bendelathouwer/Psoc_Robot/3d render voor poster.PNG

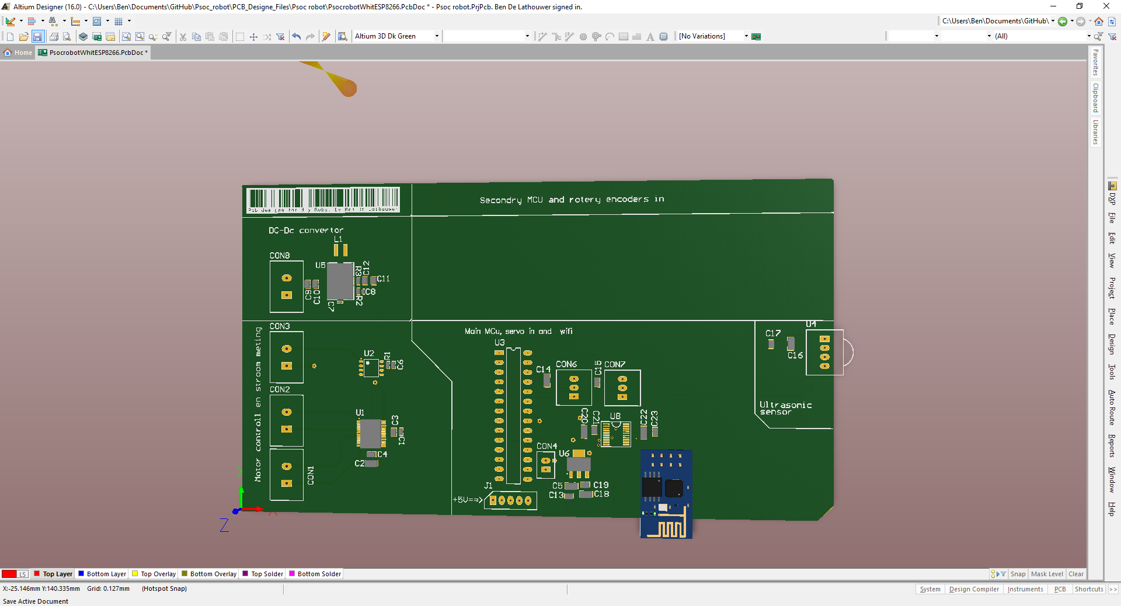
3d render voor poster.PNG
