bendelathouwer/Psoc_Robot/av/PCB_Designe_in progres.png

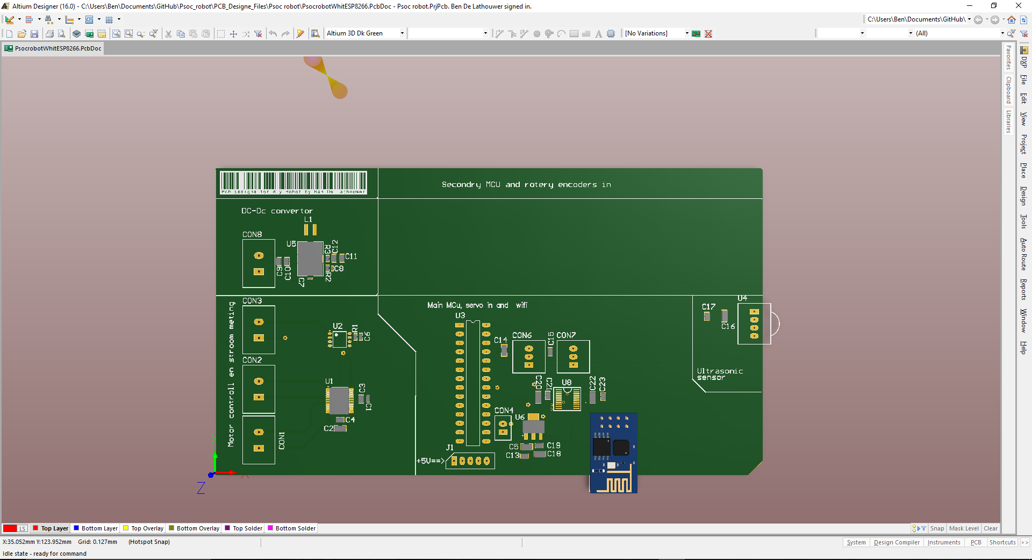
av/PCB_Designe_in progres.png
