bendelathouwer/Psoc_Robot/Psoc_robot/Psoc_robot/BuildMsg.txt

Starting MAKE...
creating project.mk 

lib/psocconfig.asm

lib/psocconfigtbl.asm

lib/pwm1.asm

lib/pwm1int.asm

lib/pwm2.asm

lib/pwm2int.asm

lib/timer1.asm

lib/timer1int.asm

lib/timer2.asm

lib/timer2int.asm

lib/timer3.asm

lib/timer3int.asm

lib/uart.asm

lib/uartint.asm

lib/uartplus.asm

./boot.asm

Linking..

LMM info: area 'InterruptRAM' uses 2 bytes in SRAM bank 0

LMM info: area 'UART_RAM' item of 16 bytes allocated in SRAM page 0

LMM info: area 'virtual_registers' uses 15 bytes in SRAM page 0

LMM info: area 'data' item of 2 bytes allocated in SRAM page 0

LMM info: area 'data' item of 2 bytes allocated in SRAM page 0

LMM info: area 'data' item of 2 bytes allocated in SRAM page 0

LMM info: area 'data' item of 2 bytes allocated in SRAM page 0

LMM info: area 'data' item of 2 bytes allocated in SRAM page 0

LMM info: area 'data' item of 2 bytes allocated in SRAM page 0

LMM info: area 'data' item of 2 bytes allocated in SRAM page 0

LMM info: area 'data' item of 2 bytes allocated in SRAM page 0

LMM info: area 'data' item of 2 bytes allocated in SRAM page 0

LMM info: area 'data' item of 1 bytes allocated in SRAM page 0

LMM info: area 'data' item of 1 bytes allocated in SRAM page 0

LMM info: area 'data' item of 1 bytes allocated in SRAM page 0

idata dump at output/Psoc_robot.idata

  ROM 19% full. 6030 out of 32768 bytes used (does not include absolute areas).

  RAM 4% full. 54 bytes used (does not include stack usage).

Built with ICCM8C STD V7.05.00

Psoc_robot - 0 error(s) 0 warning(s) 16:28:51
