bendelathouwer/Psoc_Robot/logboek2.odt

Logboek

woensdag 24/02/16 robot chasis halen 09:00=> 11 uur

Vrijdag 26/02/16 opzoeken afstands sensoren en werken aan project, propellor opblazen, ultrasoon sensor metingen 09:00=>20:00

zaterdag 27/02/2016 bestellen nieuw dev board + opzoeken gebruikte microcontroller+ datasheets verzamelen 19:00=>22:00

zondag 28/02/2016 pva schrijven en xbee's testen + uitlezen in labview nrf modulles testen 10:00=>00:00

donderdag programa verder schrijven en testen16:00 => 19:00 9 ben eveneens een baterij gaan halen (deze was leeg terwijl ik dacht mijn chip opgeblazen te hebben)

Vrijdag 09:00 =>13:00 stroomsensor board gaan halen

zaterdag 11:16=>11:47 stroommeting en beveiliging code schrijven+code opschonen

20:06=> 20:28 begin met website maken

Maandag 14/03/2016 17:19 =>19:00 Stress test procedure schrijven voor Hall efect stroom sensors

dinsdag 15/03/2016 10:20 =>10:30 print tekenen in altium

donderdag. 17/02/2016 16:10=> 21:23 libs maken in altium

vrijdag 17/03/2016 10:00=> 17:00 werken aan project

Zaterdag 19/03/2016 12:03=> 17:38 pcb tekene + ultrasoon sensor programmeren

zondag 20/03/2016 11:35=> 15:07 opnieuw programmeren van servo naar pwm code en uitbrijden voor het 2 joystick kanaal in te lezen

maandag 21/03/2016 10:00=>12:15 programmeren 2de joyjstick kanaal kunne uitlezen 50% done mark berijkt

donderdag 24/03/2016 10:00=>18:00 ultrasoon programmeren(proberen) en dc-dc convertor uitkiezen

donderdag 14/04/2016 08:15=> 14:00 pcb tekenen

/zondag 17/04/2016 13:20=>16:00 werken aan verslag

Vrijdag 22/04/2016 8:45 => schemas tekenen
