bendelathouwer/Psoc_Robot/project voorstel2/projectvoorstel2.odt

RC voertuig aansturen via xbee Ben De Lathouwer

Omschrijving : Fpga deel(VHDL):Mijn fpga gaat dienen als ground station.Onder ground station verstaan we een brod waarmee ik mijn helicopter op afstand mee kan bedienen.Eveneens ga ik hiermee een draadloze verbinding opzetten .Deze ga ik gebruiken om Vluchtdata mee te vusualiseren( onder vlucht data verstaan we bv de hoogte, snelheid, Richting,...).De visualisatie gaat gebeuren op een vga scherm( de visualisatie gaat in functie zijn van digitale project. De fpga interfacen met de xbee gaan zijn in functie van project project)

Vliegtuig gedeelte( C )

Deze gaat een bestuurings bort bevatten .Die de motoren gaan aansturen en de instrumenten gaat uitlezen .En Deze telemetrie gaat doorgestraald worden met een xbee module .

Xbee modullen . Zender blokschema:

Vga scherm FPGA FPGA FPGA

Xbee modullen . ontvanger boordcomputer boordcomputer

Telemetrie En motor stuuring

kostenraming

quadcopter 500 euro

fpga :80 euro

Print 10 euro

telemetrie:20 euro

totaal:610 euroqq
