bendelathouwer/Psoc_Robot/cross reference chart distance sensors.pdf

Blad1

vergelijkings chart afstand sensoren

type sensor | working current
HC – SR04 | 15mA
Sharp GP2YOA21 | Max 40mA
laser rage finder | 150 mA
ping sensor | 35 mA
Sonar sensor | 10mA

max dedection distance | mesuring angel
4m | 15degrees
Max 150 cm | Not found
2.54meters | Not found
3 m | Not found
5meters | Not found

price | max working voltage
€ 42,34 | 5V
: € 18,09 | 4.5 to 5.5V
| +4.5 V to +5.5 V
| +5 VDC

€ 41,14

€ 119,79

€ 36,29

12vdc (8vdc -
14vdc)

minj range | mesuering methode
2cm | ultrasound
20cm | IR
15cm | laser
: 2 cm | ultrasoon
60cm | sonar

remarks

2 pins needed trig and echo

Analog output voltage proportional to distance

high acuracy

1 pin needed to mesure distance

high distance but higer suply voltgae RS485 communication interface
