bendelathouwer/Psoc_Robot/Poort hexwaarde tabel.pdf

Poort nr | 7 | 6 | 5 | 4 | 3 | 2 | 1 | 0 | Hexwaarde | Schema naam | I | O
P2[7] | 1 | 0 | 0 | 0 | 0 | 0 | 0 | 0 | 0x80 | MOCA1A | | x | pin numer 568
p2[5] | 0 | 0 | 1 | 0 | 0 | 0 | 0 | 0 | 0x20 | MOCA1B | | x
p2[1] | 0 | 0 | 0 | 0 | 0 | 0 | 1 | 0 | 0x02 | MOCA2A | | x
p1[7] | 1 | 0 | 0 | 0 | 0 | 0 | 0 | 0 | 0x80 | MOCA2B | | x | 10
p1[5] | 0 | 0 | 1 | 0 | 0 | 0 | 0 | 0 | 0x20 | Stby | | x | 11
p2[6] | 0 | 1 | 0 | 0 | 0 | 0 | 0 | 0 | 0x40 | Fault | x | | 23
p2[2] | 0 | 0 | 0 | 0 | 0 | 1 | 0 | 0 | 0x04 | OE | | x | 21
p2[0] | 0 | 0 | 0 | 0 | 0 | 0 | 0 | 1 | 0x01 | GPIO2 | | | 20
P1[6] | 0 | 1 | 0 | 0 | 0 | 0 | 0 | 0 | 0x40 | CH_PD | | | 18
p1[4] | 0 | 0 | 0 | 1 | 0 | 0 | 0 | 0 | 0x10 | GPIO0 | | | 17
p1[2] | 0 | 0 | 0 | 0 | 0 | 1 | 0 | 0 | 0x04 | GPIO16 | | | 16
