bendelathouwer/Psoc_Robot/av/20160522_125724.jpg

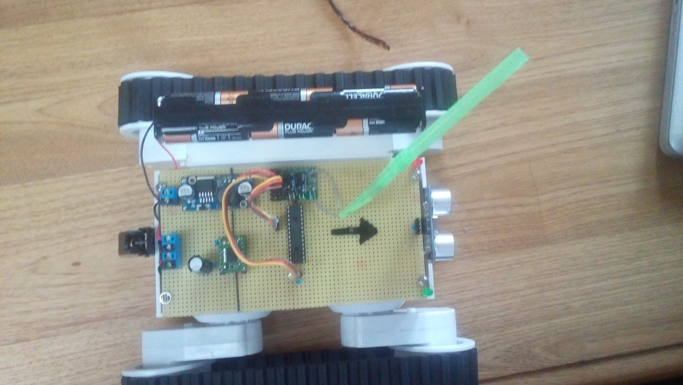
av/20160522_125724.jpg
