bendelathouwer/Psoc_Robot/av/20160522_132219.jpg

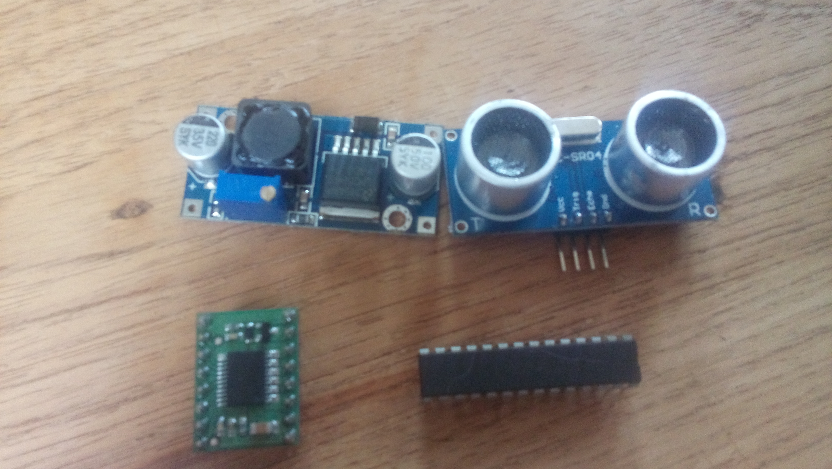
av/20160522_132219.jpg
