bendelathouwer/Psoc_Robot/av/IMG_5507.JPG

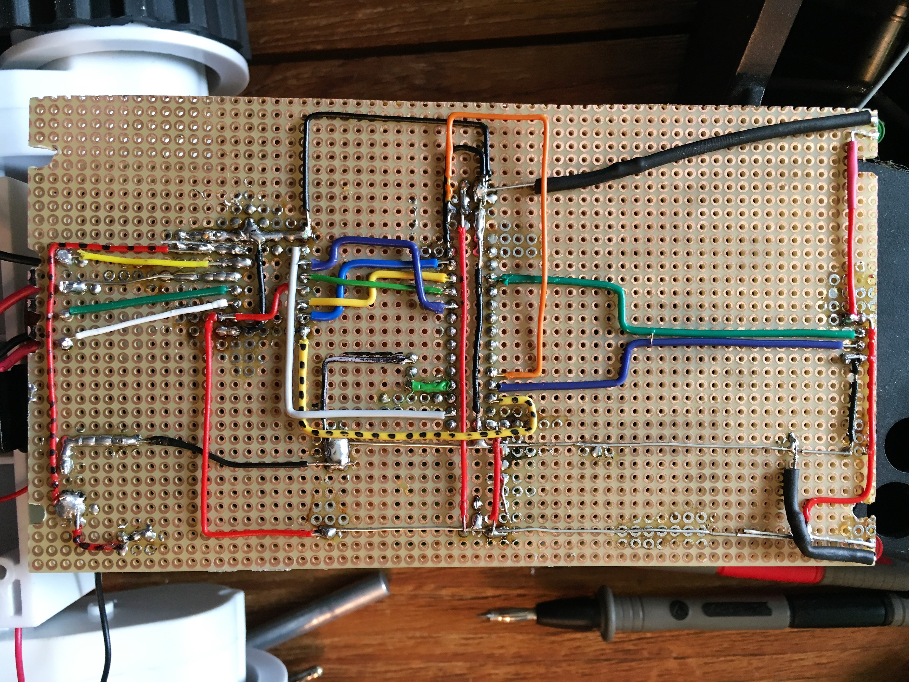
av/IMG_5507.JPG
