bendelathouwer/Psoc_Robot/av/IMG_5508.JPG

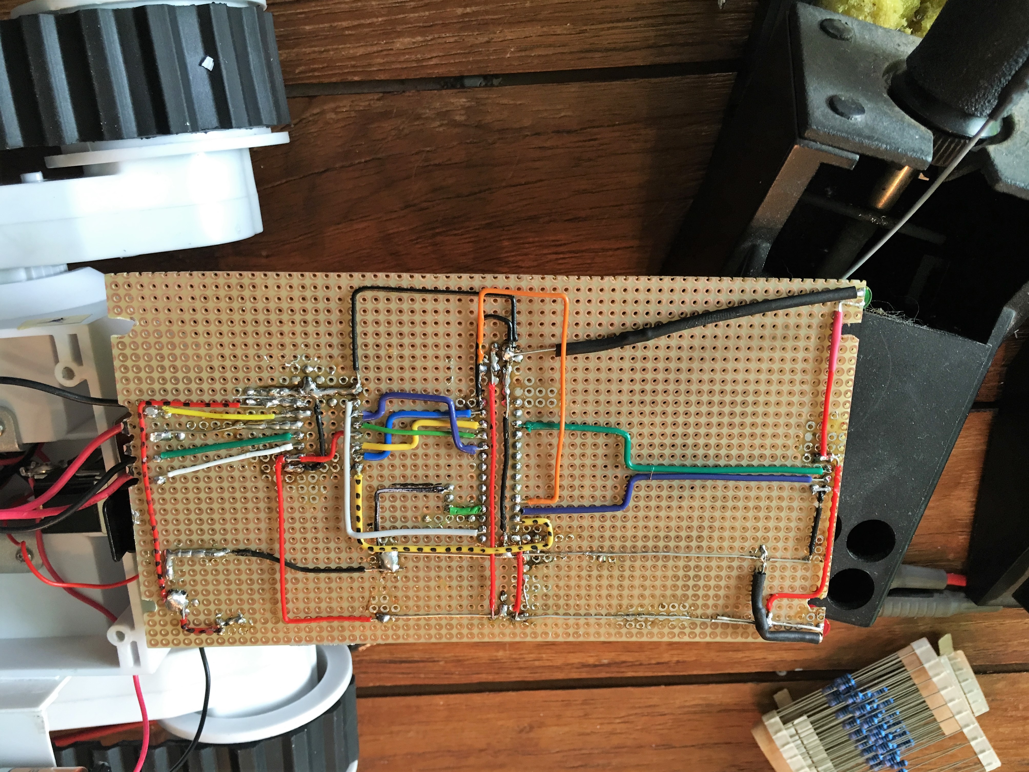
av/IMG_5508.JPG
