bendelathouwer/Psoc_Robot/av/IMG_5509.JPG

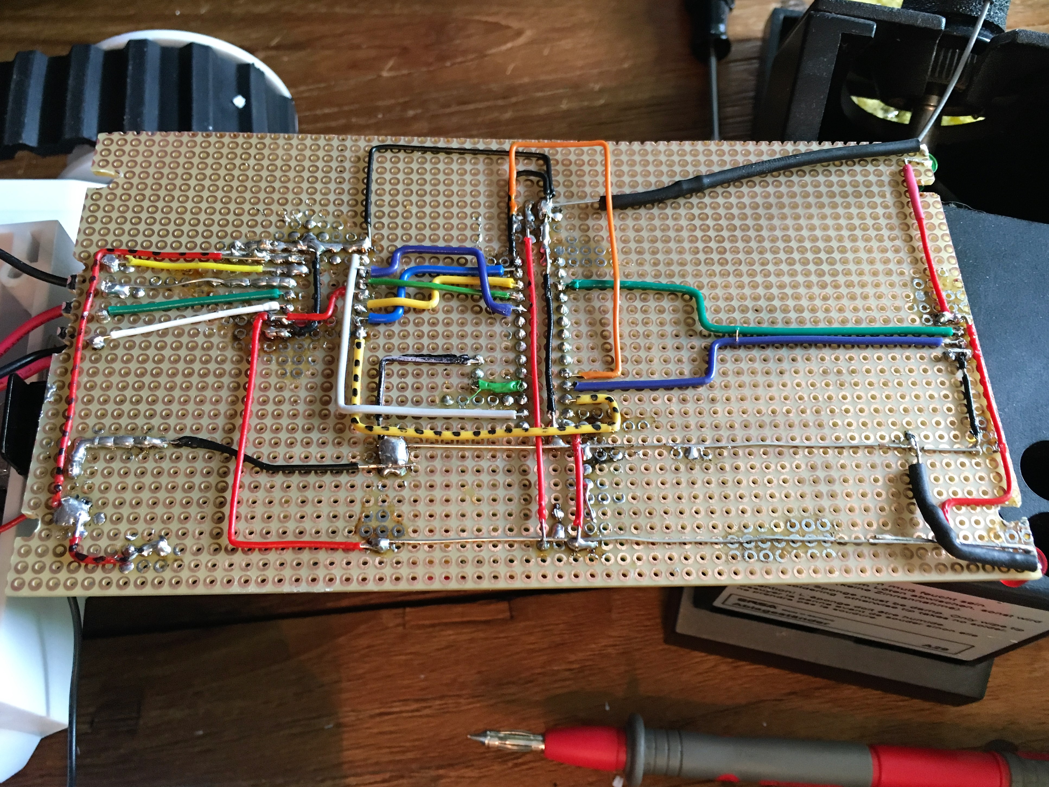
av/IMG_5509.JPG
