bendelathouwer/Psoc_Robot/av/IMG_5510.JPG

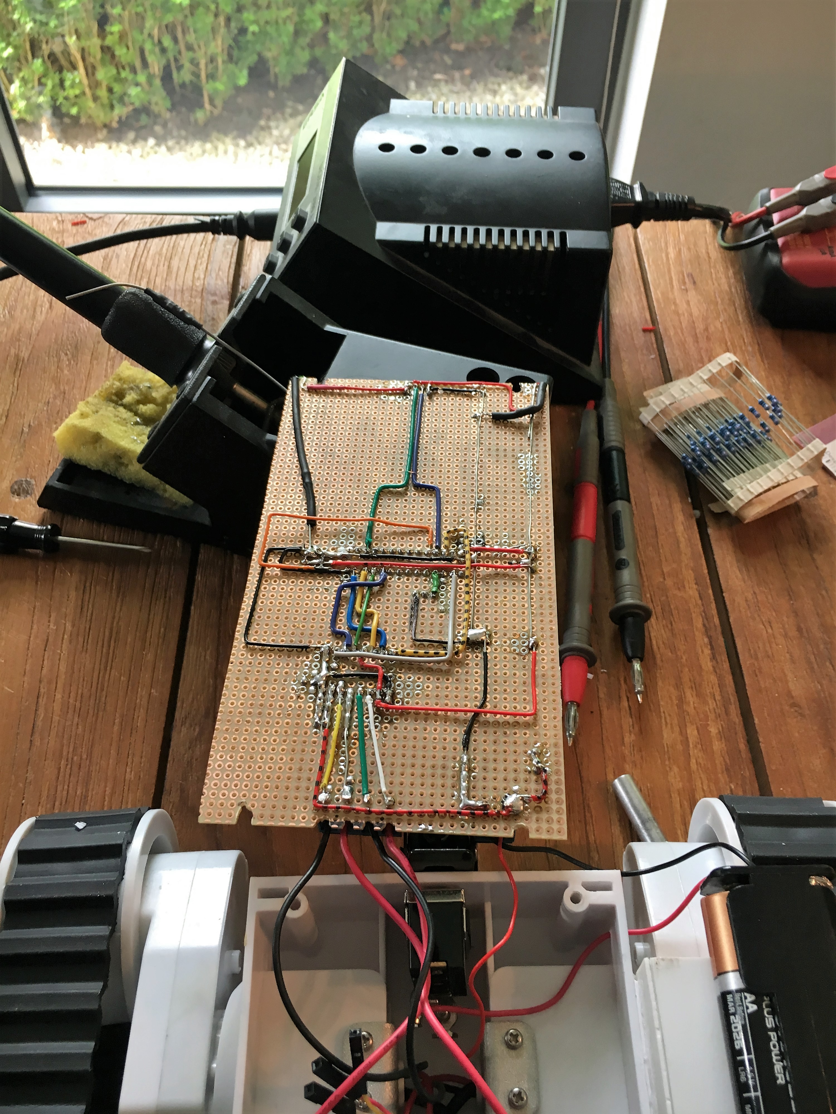
av/IMG_5510.JPG
