bendelathouwer/Psoc_Robot/av/IMG_5511.JPG

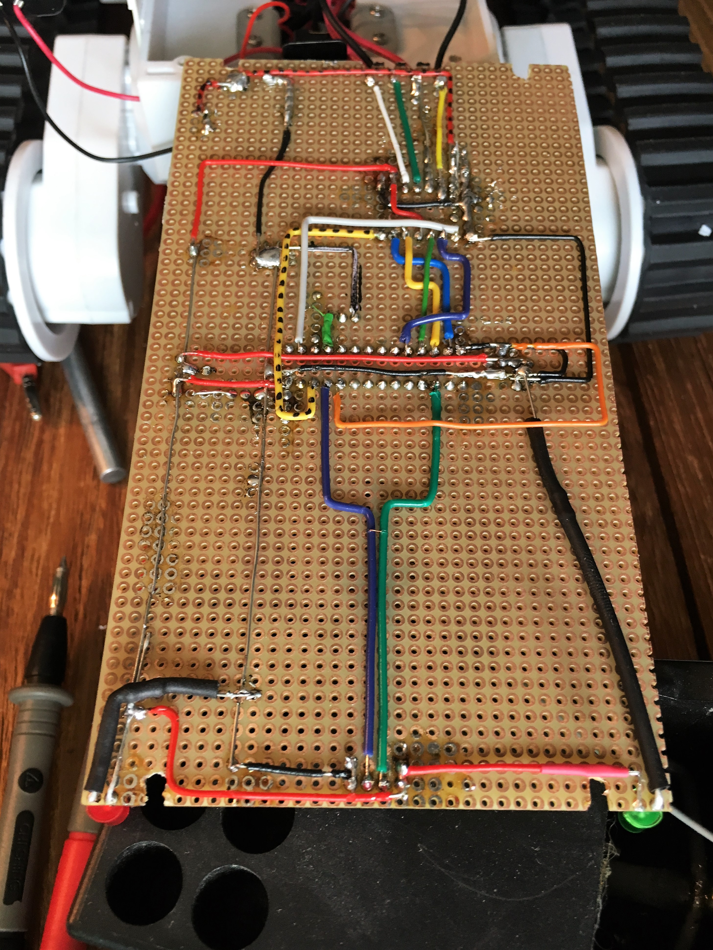
av/IMG_5511.JPG
