bendelathouwer/Psoc_Robot/av/IMG_5512.JPG

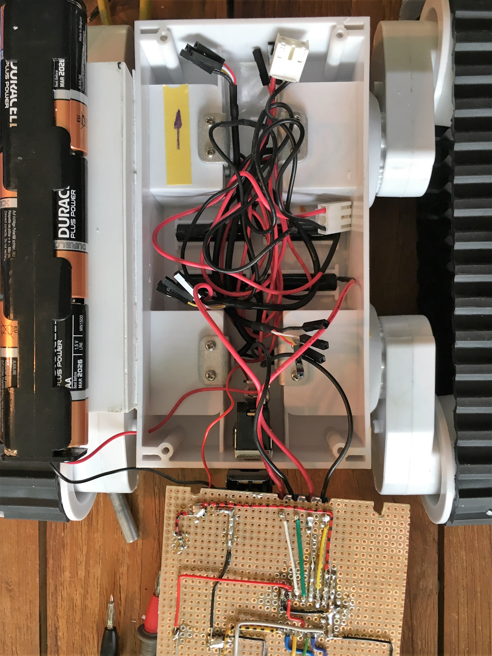
av/IMG_5512.JPG
