bendelathouwer/Psoc_Robot/av/interne van motordriver.PNG

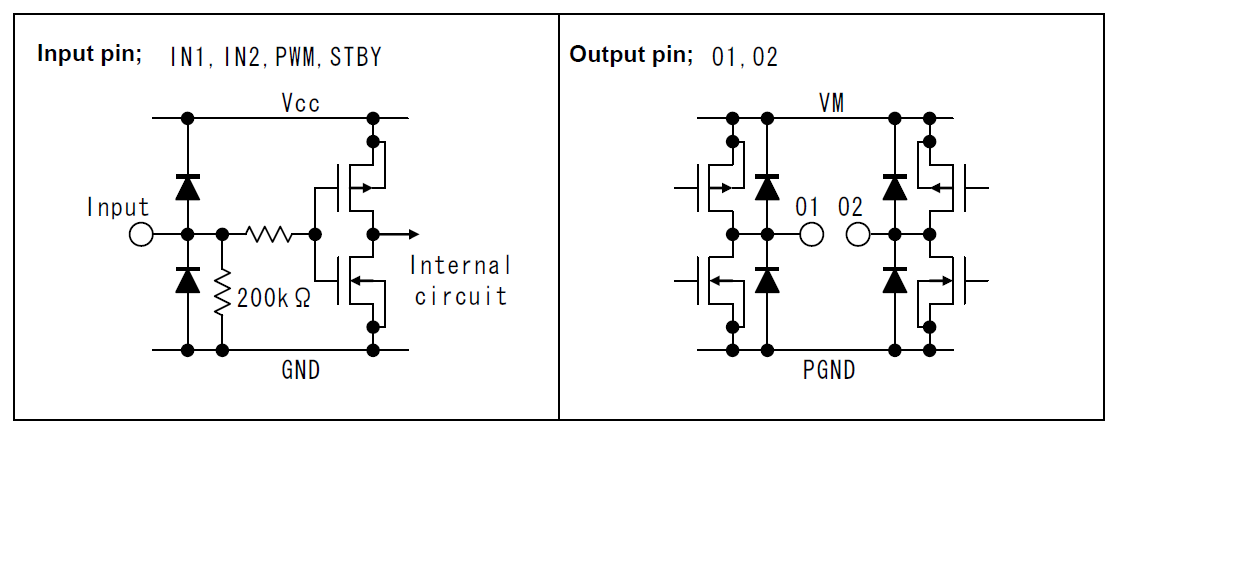
av/interne van motordriver.PNG
