bendelathouwer/Psoc_Robot/av/programeer omgeving poster.PNG

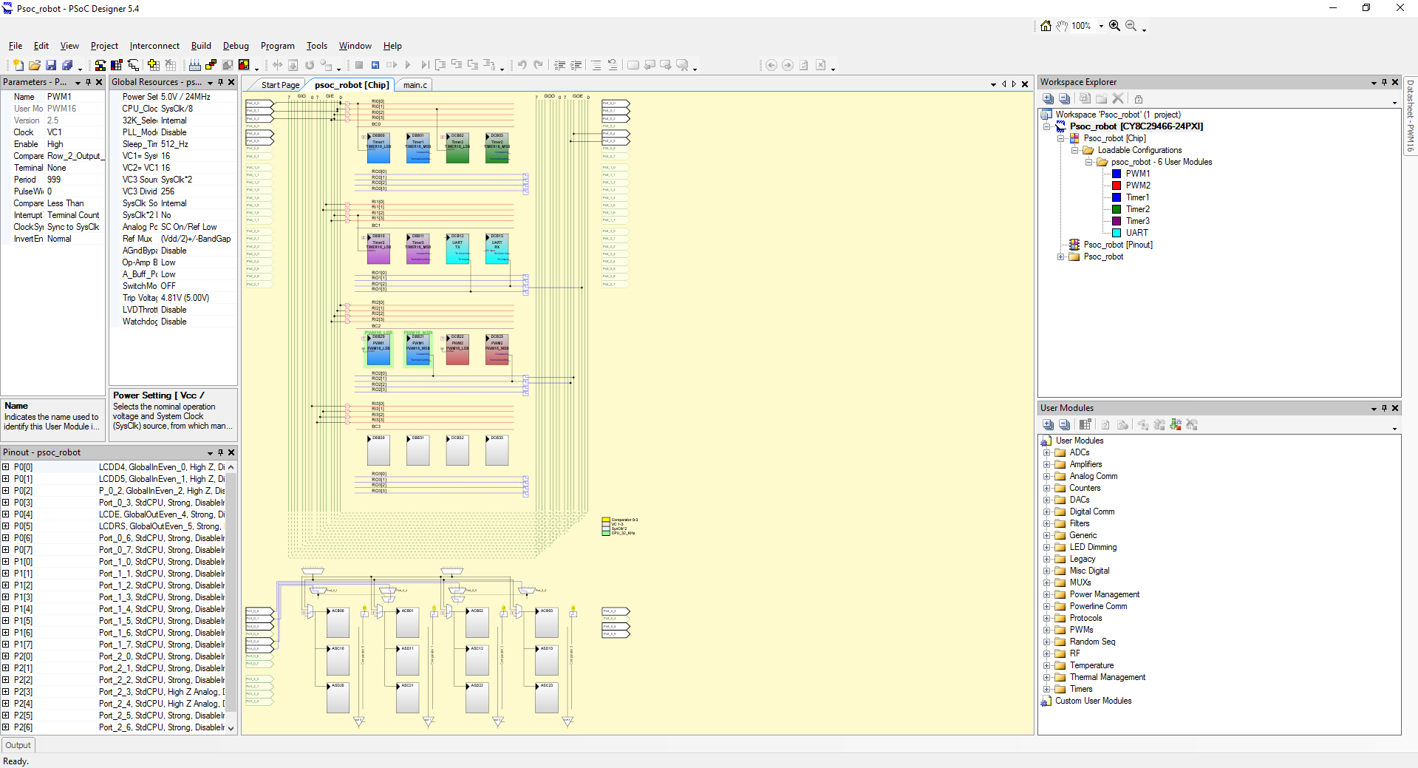
av/programeer omgeving poster.PNG
