bendelathouwer/Psoc_Robot/av/Programeer omgeving.png

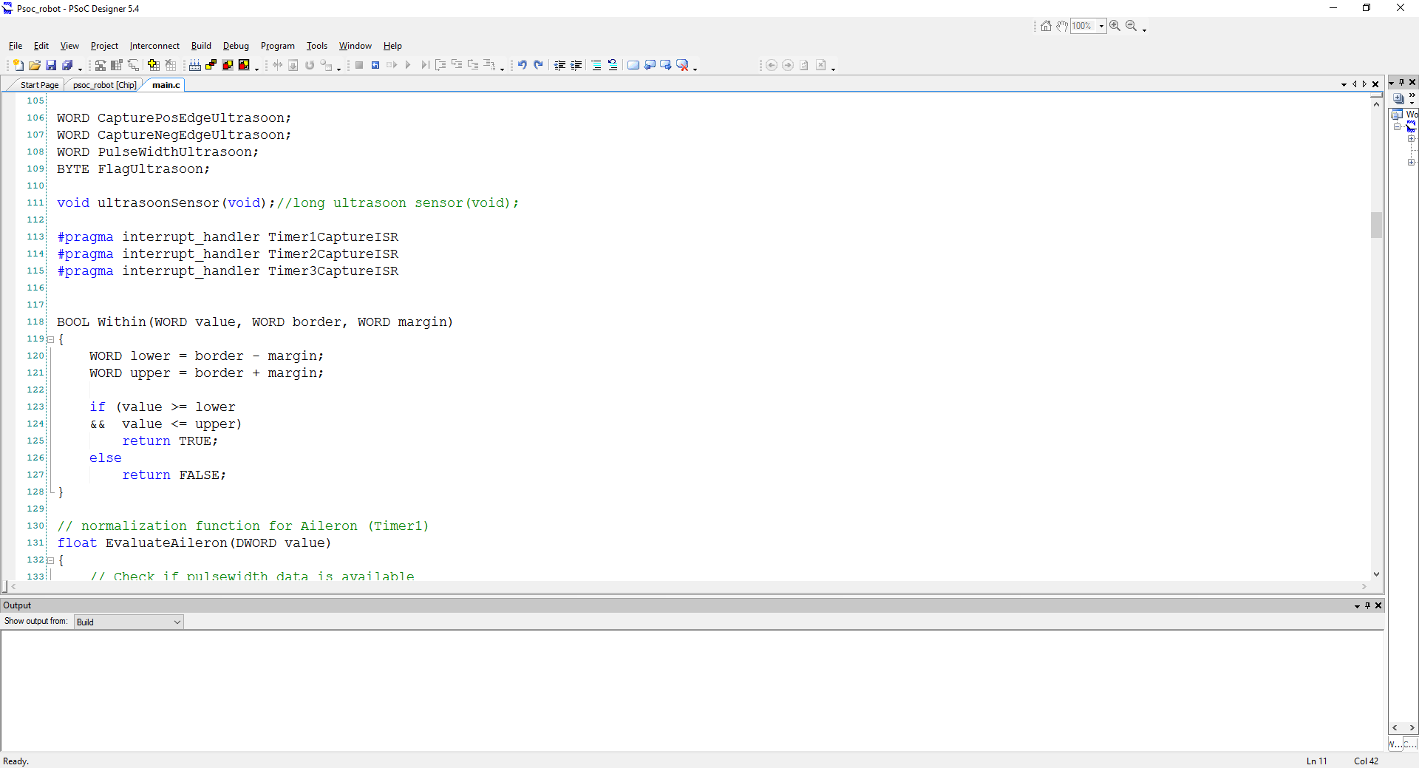
av/Programeer omgeving.png
