bendelathouwer/Psoc_Robot/av/robot.jpg

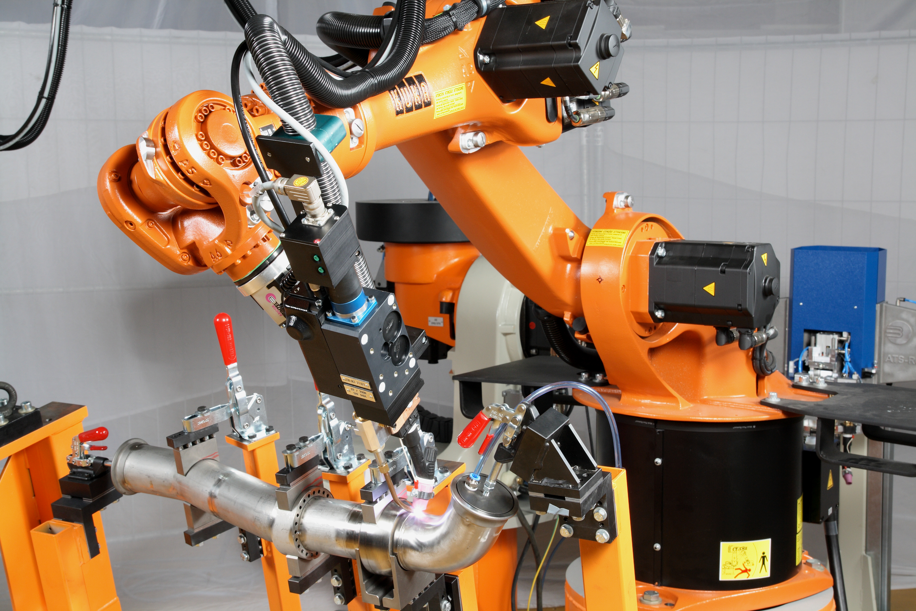
av/robot.jpg
