bendelathouwer/Psoc_Robot/landing patrn crystal.PNG

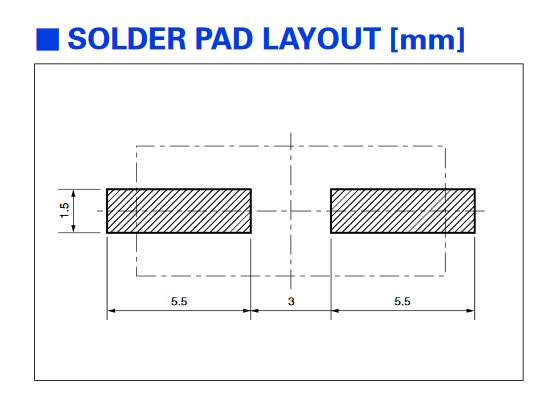
landing patrn crystal.PNG
