bendelathouwer/Psoc_Robot/metingen/F0000TEK.JPG

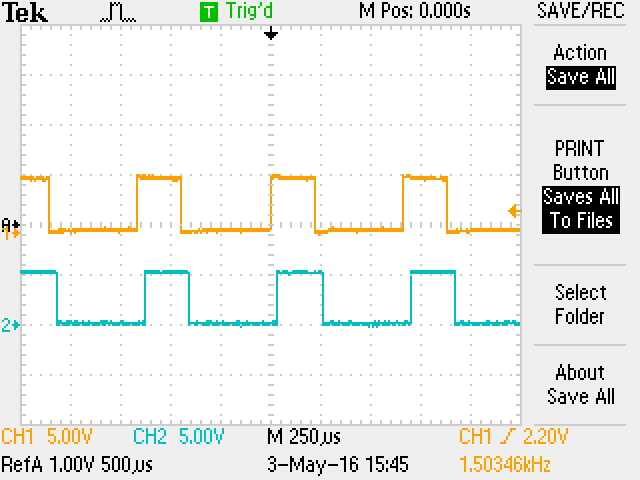
metingen/F0000TEK.JPG
