bendelathouwer/Psoc_Robot/metingen/pwm0.jpg

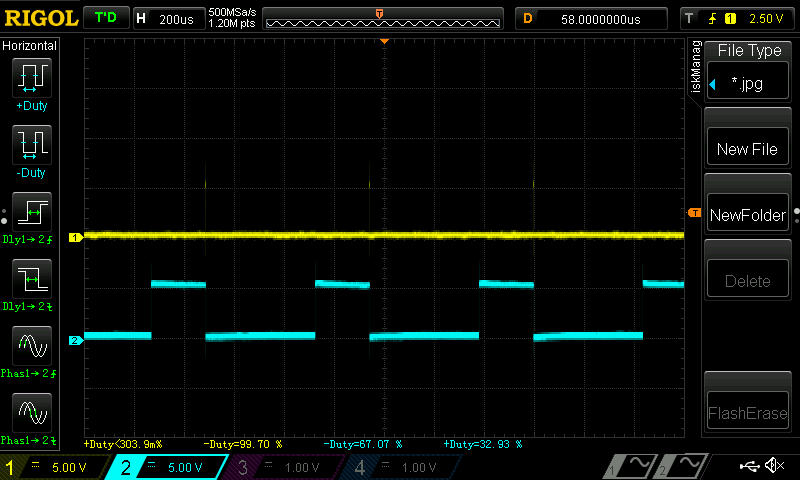
metingen/pwm0.jpg
