bendelathouwer/Psoc_Robot/psoc_Counter_Settings.jpg

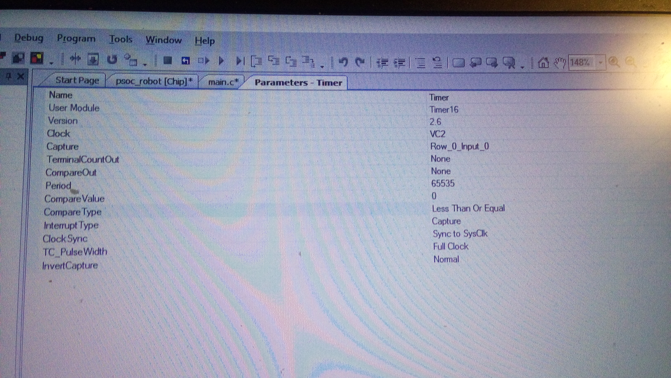
psoc_Counter_Settings.jpg
