bendelathouwer/Psoc_Robot/RCsigPic.jpg

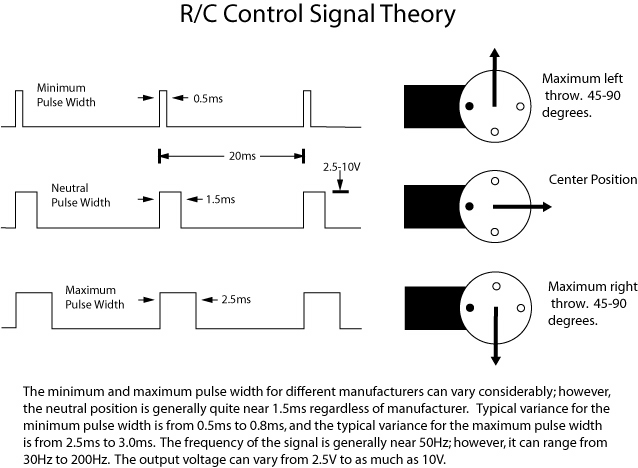
RCsigPic.jpg
