bendelathouwer/Psoc_Robot/bom.odt

http://be.farnell.com/vishay-dale/crcw06031m00jnea/thick-film-resistor-1mohm-100mw/dp/1514706 10x

http://be.farnell.com/tdk/c2012x5r1c226k125ac/cap-mlcc-x5r-22uf-16v-0805/dp/2346925 10x

http://www.mouser.be/ProductDetail/Toshiba/TB6612FNGC8EL/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 10x


http://www.mouser.be/ProductDetail/Texas-Instruments/TPS63061DSCR/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 10x

http://be.farnell.com/allegro-microsystems/acs711klctr-12ab-t/current-sensor-12-5a-3-3v-8soic/dp/2057423 10x

http://be.farnell.com/walsin/0603b104k500ct/capacitor-mlcc-x7r-0-1uf-50v-0603/dp/2496834?MER=en-me-sr-b-all 10x

http://be.farnell.com/avx/08056c106kat2a/cap-mlcc-x7r-10uf-6-3v-0805/dp/1657936 10x

http://be.farnell.com/multicomp/mc0402n100f500ct/ceramic-capacitor-10pf-50v-c0g/dp/1709776 10x

http://be.farnell.com/vishay-dale/crcw1206120kfkea/res-thick-film-120k-1-0-25w-1206/dp/2316152 10x

http://www.mouser.be/ProductDetail/Coilcraft/XFL4020-102MEC/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 10x
