bendelathouwer/Psoc_Robot/cross reference chart distance sensors.ods

vergelijkings chart afstand sensoren
type sensor | working current | max dedection distance | mesuring angel | price | max working voltage | minj range | mesuering methode | remarks
HC – SR04 | 15mA | 4m | 15degrees | € 42,34 | 5V | 2cm | ultrasound | 2 pins needed trig and echo
Sharp GP2YOA21 | Max 40mA | Max 150 cm | Not found | : € 18,09 | 4.5 to 5.5V | 20cm | IR | Analog output voltage proportional to distance
laser rage finder | 150 mA | 2.54meters | Not found | € 119,79 | +4.5 V to +5.5 V | 15cm | laser | high acuracy
ping sensor | 35 mA | 3 m | Not found | € 36,29 | +5 VDC | : 2 cm | ultrasoon | 1 pin needed to mesure distance
Sonar sensor | 10mA | 5meters | Not found | € 41,14 | 12vdc (8vdc - 14vdc) | 60cm | sonar | high distance but higer suply voltgae RS485 communication interface
