bendelathouwer/Psoc_Robot/Pwm_Test/Pwm_Test/Pwm_Test/BuildMsg.txt

Starting MAKE...
creating project.mk 

lib/psocconfig.asm

lib/psocconfigtbl.asm

lib/pwm.asm

lib/pwm2.asm

lib/pwm2int.asm

lib/pwmint.asm

./boot.asm

Linking..

LMM info: area 'virtual_registers' uses 2 bytes in SRAM page 0

idata dump at output/Pwm_Test.idata

  ROM 3% full. 908 out of 32768 bytes used (does not include absolute areas).

  RAM 1% full. 2 bytes used (does not include stack usage).

Built with ICCM8C STD V7.05.00

Pwm_Test - 0 error(s) 0 warning(s) 15:45:02
