bendelathouwer/Psoc_Robot/UltrasoonTest/UltrasoonTest/UltrasoonTest/BuildMsg.txt

Starting MAKE...
creating project.mk 

lib/lcd.asm

lib/psocconfig.asm

lib/psocconfigtbl.asm

lib/timer.asm

lib/timerint.asm

./boot.asm

Linking..

LMM info: area 'InterruptRAM' uses 3 bytes in SRAM bank 0

LMM info: area 'virtual_registers' uses 15 bytes in SRAM page 0

LMM info: area 'data' item of 2 bytes allocated in SRAM page 0

LMM info: area 'data' item of 2 bytes allocated in SRAM page 0

LMM info: area 'data' item of 2 bytes allocated in SRAM page 0

LMM info: area 'data' item of 1 bytes allocated in SRAM page 0

idata dump at output/UltrasoonTest.idata

  ROM 5% full. 1623 out of 32768 bytes used (does not include absolute areas).

  RAM 2% full. 25 bytes used (does not include stack usage).

Built with ICCM8C STD V7.05.00

UltrasoonTest - 0 error(s) 0 warning(s) 21:08:01
