bendelathouwer/Psoc_Robot/PulsTest/PulsTest/PulsTest/BuildMsg.txt

Starting MAKE...
creating project.mk 

lib/psocconfig.asm

lib/psocconfigtbl.asm

./boot.asm

Linking..

LMM info: area 'virtual_registers' uses 2 bytes in SRAM page 0

idata dump at output/PulsTest.idata

  ROM 2% full. 507 out of 32768 bytes used (does not include absolute areas).

  RAM 1% full. 2 bytes used (does not include stack usage).

Built with ICCM8C STD V7.05.00

PulsTest - 0 error(s) 0 warning(s) 16:11:08
