bendelathouwer/Psoc_Robot/av/Print voor poter.PNG

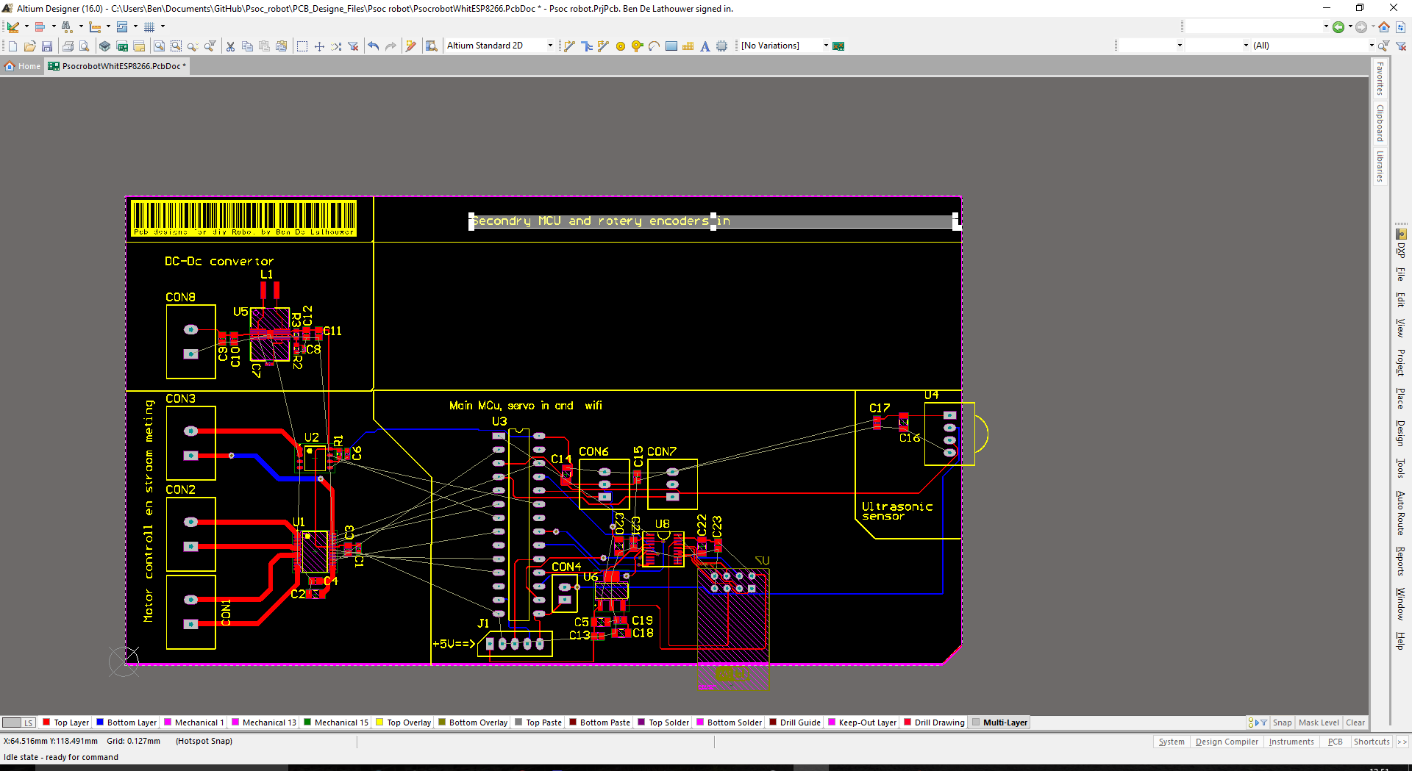
av/Print voor poter.PNG
