bendelathouwer/Psoc_Robot/(list of files, drawings)

Other design files:
PCB_Designe_Files/Psoc robot/2PinsHeader.PcbLib
PCB_Designe_Files/Psoc robot/2pinsHeader.SchLib
PCB_Designe_Files/Psoc robot/ACS711.PcbLib
PCB_Designe_Files/Psoc robot/ACS711.SchLib
PCB_Designe_Files/Psoc robot/ATMEGA126.SchLib
PCB_Designe_Files/Psoc robot/ATmega162.PcbLib
PCB_Designe_Files/Psoc robot/Atmega.SchDoc
PCB_Designe_Files/Psoc robot/coil.PcbLib
PCB_Designe_Files/Psoc robot/COIL.SchLib
PCB_Designe_Files/Psoc robot/currentSensor.SchDoc
PCB_Designe_Files/Psoc robot/cY8c29466.PcbLib
PCB_Designe_Files/Psoc robot/CY8C29466.SchLib
PCB_Designe_Files/Psoc robot/ESP8266.SchDoc
PCB_Designe_Files/Psoc robot/ESP8266.SchLib
PCB_Designe_Files/Psoc robot/IISP_Header.PcbLib
PCB_Designe_Files/Psoc robot/IISP_Header.SchLib
PCB_Designe_Files/Psoc robot/iispHeader.PcbLib
PCB_Designe_Files/Psoc robot/LM7805.SchLib
PCB_Designe_Files/Psoc robot/MC34063 .SchLib
PCB_Designe_Files/Psoc robot/MC34063.PcbLib
PCB_Designe_Files/Psoc robot/motor.SchDoc
PCB_Designe_Files/Psoc robot/Psoc robot.PrjPcb
PCB_Designe_Files/Psoc robot/Psoc-robot.SchDoc
PCB_Designe_Files/Psoc robot/PsocrobotWhitESP8266.PcbDoc
PCB_Designe_Files/Psoc robot/PSU.SchDoc
PCB_Designe_Files/Psoc robot/RcCon.PcbLib
PCB_Designe_Files/Psoc robot/RcCon.SchLib
PCB_Designe_Files/Psoc robot/Reciever.SchDoc
PCB_Designe_Files/Psoc robot/ScewTerminal.SchLib
PCB_Designe_Files/Psoc robot/Schlib1.SchLib
PCB_Designe_Files/Psoc robot/secondery controller.SchDoc
PCB_Designe_Files/Psoc robot/SrcewTerminal.PcbLib
PCB_Designe_Files/Psoc robot/TB6612FNG.PcbLib
PCB_Designe_Files/Psoc robot/TB6612FNGSCHLIB.SCHLIB
PCB_Designe_Files/Psoc robot/top.SchDoc
PCB_Designe_Files/Psoc robot/TPS630xx.SchLib
PCB_Designe_Files/Psoc robot/TPS690xx.PcbLib
PCB_Designe_Files/Psoc robot/TXB0108.PcbLib
PCB_Designe_Files/Psoc robot/TXB0108.SchLib
PCB_Designe_Files/Psoc robot/ultrasoon.SchLib
PCB_Designe_Files/Psoc robot/ultrasoonSensor.PcbLib
PCB_Designe_Files/Psoc robot/UltraSoonSensor.SchDoc
