bendelathouwer/Psoc_Robot/PulsTest/PulsTest/PulsTest/main.c

//----------------------------------------------------------------------------
// C main line
//----------------------------------------------------------------------------

#include <m8c.h>        // part specific constants and macros
#include "PSoCAPI.h"    // PSoC API definitions for all User Modules


void main(void)
{
	// M8C_EnableGInt ; // Uncomment this line to enable Global Interrupts
	// Insert your main routine code here.
	while (TRUE)
	{
		PRT2DR |= 0x01;// setting pin1[0]
  	    asm("nop");
		asm("nop");
		asm("nop");
		asm("nop");
		asm("nop");
		asm("nop");
		asm("nop");
		asm("nop");
		asm("nop");
		asm("nop");
		asm("nop");
		asm("nop");
		asm("nop");
		asm("nop");
		asm("nop");
		asm("nop");
		asm("nop");
		asm("nop");
		PRT2DR &= ~0x01;// clearing  pin P1[0]
	}
}
