bendelathouwer/Psoc_Robot/(commit log)

2016-03-12 Start of the robot project.
    Stated making the github page for the robot. and started writing the
    code . to drive the motors using an rc transmittor. Alse you can find
    the administrative documents here
    [cross reference chart distance sensors.ods]
2016-03-12 Test code for arduino
2016-03-14 Logboekv5 and new test procedures
    New Logbook etry and added test procedure for te current sensors
2016-03-15 datasheets added and Logbookv6 + dont'use map
    Added new datasheets and also added a map whit the datasheet's of
    components that dind't make the project
    [Psoc robot.PrjPcb, Psoc-robot.SchDoc]
2016-03-15 Pcb files
    Started disigning in altium for the main board
    [Psoc robot.PrjPcb]
2016-03-17 Logbookv8 and altium libs
    added new logbook entry and started working on the altium libary's
    [ACS711.SchLib, CY8C29466.SchLib, Psoc robot.PrjPcb, Psoc-robot.SchDoc]
2016-03-18 Schematic lib V2 and datasheets v3
    added new schematic parts an added new datasheet
    [CY8C29466.SchLib, Psoc-robot.SchDoc, TB6612FNGSCHLIB.SCHLIB]
2016-03-19 Datasheet v4 and pcb v3
    added new and moved datasheet entry's and added new altium libs
    [ACS711.PcbLib, ACS711.SchLib, CY8C29466.SchLib, MC34063 .SchLib, MC34063.PcbLib, PSU.SchDoc, PcbLib1.PcbLib, Psoc robot.PrjPcb]
2016-03-22 datasheet and added code for joystick and ultrasonic sensor
    [PcbLib1.PcbLib, Psoc robot.PrjPcb, TB6612FNG.PcbLib, TB6612FNGSCHLIB.SCHLIB, top.SchDoc, ultrasoon.SchLib]
2016-03-24 added new psoc lib and new logbook entry
    [PSU.SchDoc, Psoc-robot.SchDoc]
2016-04-08 removed unused fils from vhdl project
    [PSU.SchDoc]
2016-04-17 verslag V1 and altium pcb
    started on verslag en startet to draw a pcb
    [2PinsHeader.PcbLib, 2pinsHeader.SchLib, ACS711.PcbLib, ACS711.SchLib, COIL.SchLib, CY8C29466.SchLib, IISP_Header.PcbLib, IISP_Header.SchLib]
2016-04-20 PCB and verslag
    [ACS711.SchLib, CY8C29466.SchLib, PSU.SchDoc, Psocrobot.PcbDoc, TB6612FNGSCHLIB.SCHLIB, motor.SchDoc]
2016-04-22 new pcb files
    added esp8266 to the board
    [2pinsHeader.SchLib, ACS711.PcbLib, ACS711.SchLib, CY8C29466.SchLib, ESP8266.SchDoc, ESP8266.SchLib, IISP_Header.SchLib, LM7805.SchLib]
2016-04-23 pcb
    resolvede problems whit altium (nearly all the problems)
    [ESP8266.SchDoc, PSU.SchDoc, Psoc robot.PrjPcb, Psoc-robot.SchDoc, PsocrobotWhitESP8266.PcbDoc, RcCon.PcbLib, Reciever.SchDoc, UltraSoonSensor.SchDoc]
2016-04-24 pcb and verslag
    contiunud op pcb files and paper
    [PsocrobotWhitESP8266.PcbDoc]
2016-04-25 pcb
    component placement on pcb
    [PsocrobotWhitESP8266.PcbDoc]
2016-04-26 pcb
    pcb designe next steps
    [PsocrobotWhitESP8266.PcbDoc]
2016-04-26 pcb
    pcb steps taken
    [PsocrobotWhitESP8266.PcbDoc]
2016-04-28 pcb
    component placement on the pcb and started routing
    [PsocrobotWhitESP8266.PcbDoc, Reciever.SchDoc]
2016-05-02 pwm and psoc robot programma
    fixed pwm problem
    [main.c]
2016-05-03 mesuerments and programm v8
    added new mesurments and finishing programming
    [F0000CH1.CSV, F0000CH2.CSV, F0000RFA.CSV, PsocrobotWhitESP8266.PcbDoc]
2016-05-05 exceel + datasheet
    Added excel sheet gate to hex value and added datasheet dor atmega162
    [Poort hexwaarde tabel.xlsx, PsocrobotWhitESP8266.PcbDoc]
2016-05-05 excel sheet
    expanded the excell sheet whit the actual pin numbers
    [Poort hexwaarde tabel.xlsx]
2016-05-08 code
    finishing code up only motordriver needs some work
2016-05-09 atmega lib
    started drowing lib for atmega lib
    [ATMEGA126.SchLib, Psoc robot.PrjPcb, PsocrobotWhitESP8266.PcbDoc]
2016-05-16 psoc robot code and altium files
    code finished and continuid working on pcb
    [ATMEGA126.SchLib, ATmega162.PcbLib, Atmega.SchDoc, ESP8266.SchDoc, PSU.SchDoc, Poort hexwaarde tabel.xlsx, Psoc robot.PrjPcb, Psoc-robot.SchDoc]
2016-05-22 poster
    made poster
    [ATMEGA126.SchLib, ATmega162.PcbLib, Atmega.SchDoc, Psoc robot.PrjPcb, Psoc-robot.SchDoc, PsocrobotWhitESP8266.PcbDoc, top.SchDoc]
